malsyned/dparticular/enclosure.FCStd

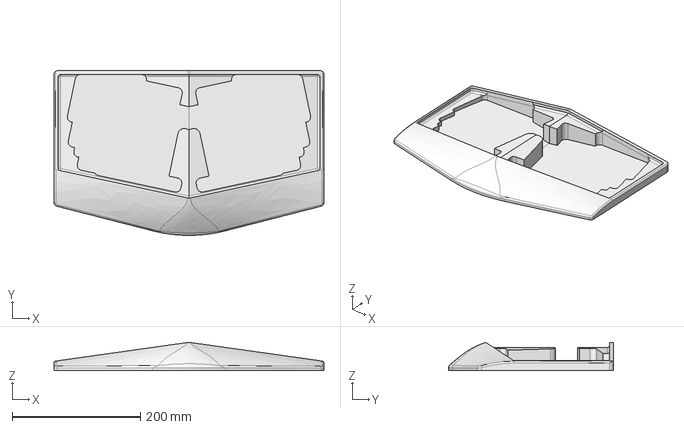
[picture p1: CAD file, 2020-10-07]
enclosure.FCStd
421.7 x 257.6 x 44.1 mm
