malsyned/dparticular/dparticular_left.kicad_pcb

## KiCad design dparticular_left.kicad_pcb (2020-08-25)

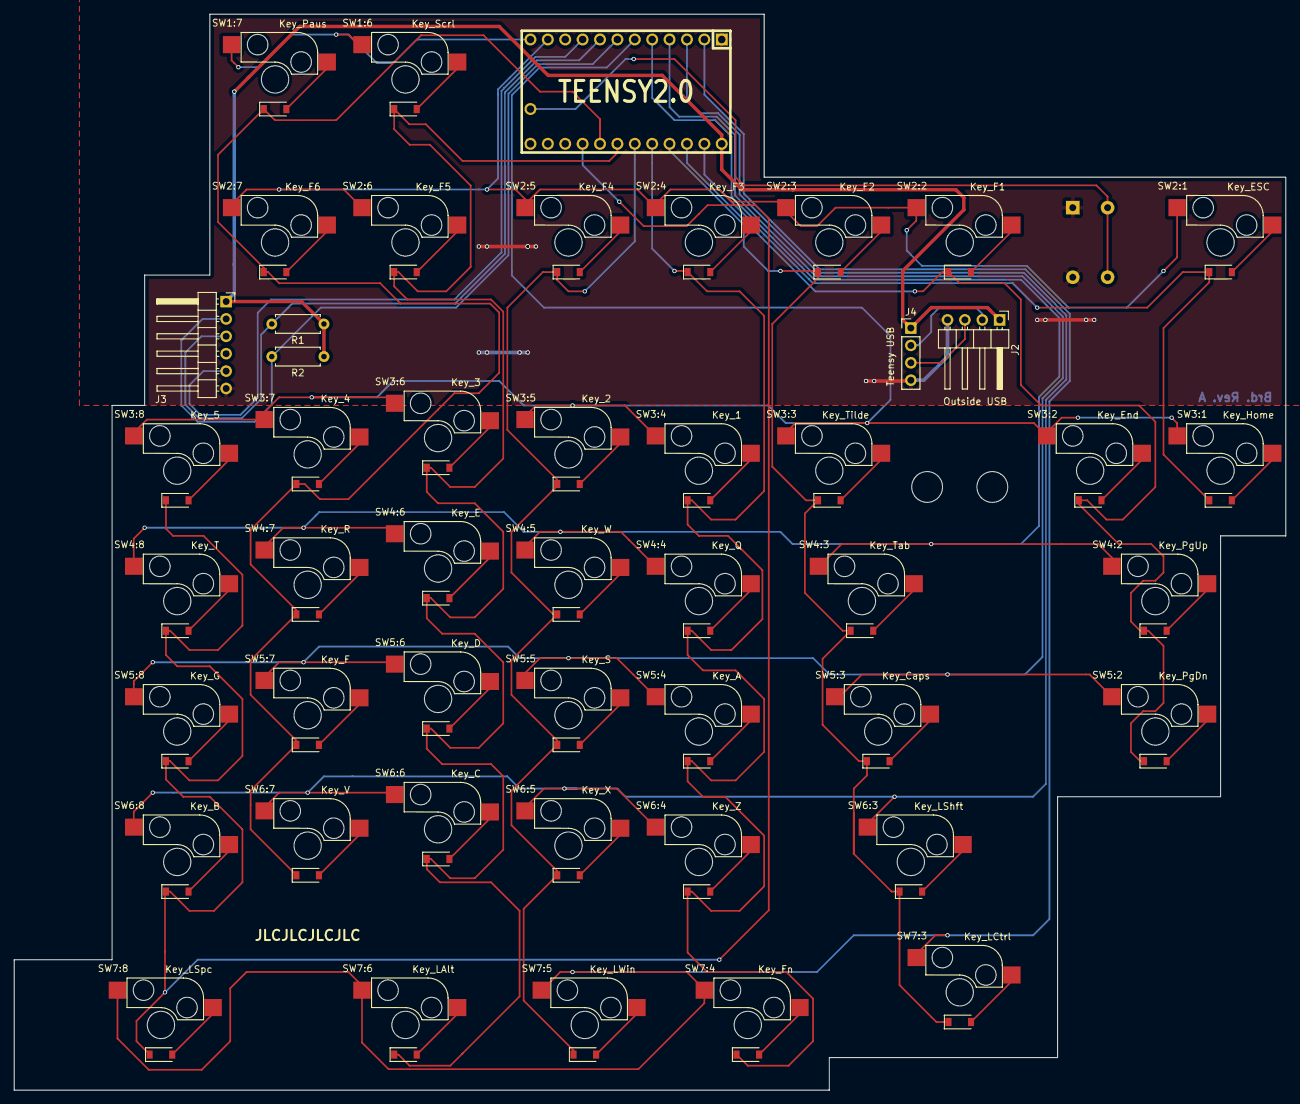
[picture p2: board dparticular_left.kicad_pcb from above]

Board: 2 copper layers, 185.7 x 157.2 mm, 51 parts (1 on the bottom side), 65 nets.

Parts:
H1: USB Strain L; MountingHole_4.5mm
H2: USB Strain R; MountingHole_4.5mm
J2: Outside USB; PinHeader_1x04_P2.54mm_Horizontal
J3: To Right Hand; PinHeader_1x06_P2.54mm_Horizontal
J4: Teensy USB; PinHeader_1x04_P2.54mm_Vertical
R1, R2: 4.7k; R_Axial_DIN0207_L6.3mm_D2.5mm_P7.62mm_Horizontal
SW1: Reset; JB15KP-2A
SW1:6: Key_Scrl; MX_W_DIODE
SW1:7: Key_Paus; MX_W_DIODE
SW2:1: Key_ESC; MX_W_DIODE
SW2:2: Key_F1; MX_W_DIODE
SW2:3: Key_F2; MX_W_DIODE
SW2:4: Key_F3; MX_W_DIODE
SW2:5: Key_F4; MX_W_DIODE
SW2:6: Key_F5; MX_W_DIODE
SW2:7: Key_F6; MX_W_DIODE
SW3:1: Key_Home; MX_W_DIODE
SW3:2: Key_End; MX_W_DIODE
SW3:3: Key_Tilde; MX_W_DIODE
SW3:4: Key_1; MX_W_DIODE
SW3:5: Key_2; MX_W_DIODE
SW3:6: Key_3; MX_W_DIODE
SW3:7: Key_4; MX_W_DIODE
SW3:8: Key_5; MX_W_DIODE
SW4:2: Key_PgUp; MX_W_DIODE
SW4:3: Key_Tab; MX_W_DIODE
SW4:4: Key_Q; MX_W_DIODE
SW4:5: Key_W; MX_W_DIODE
SW4:6: Key_E; MX_W_DIODE
SW4:7: Key_R; MX_W_DIODE
SW4:8: Key_T; MX_W_DIODE
SW5:2: Key_PgDn; MX_W_DIODE
SW5:3: Key_Caps; MX_W_DIODE
SW5:4: Key_A; MX_W_DIODE
SW5:5: Key_S; MX_W_DIODE
SW5:6: Key_D; MX_W_DIODE
SW5:7: Key_F; MX_W_DIODE
SW5:8: Key_G; MX_W_DIODE
SW6:3: Key_LShft; MX_W_DIODE
SW6:4: Key_Z; MX_W_DIODE
SW6:5: Key_X; MX_W_DIODE
SW6:6: Key_C; MX_W_DIODE
SW6:7: Key_V; MX_W_DIODE
SW6:8: Key_B; MX_W_DIODE
SW7:3: Key_LCtrl; MX_W_DIODE
SW7:4: Key_Fn; MX_W_DIODE
SW7:5: Key_LWin; MX_W_DIODE
SW7:6: Key_LAlt; MX_W_DIODE
SW7:8: Key_LSpc; MX_W_DIODE
U2: TEENSY2.0; TEENSY_2.0_EDGES_ONLY

Connections:
+5V: J2.1, J3.1, J4.1, R1.1, R2.1, U2.29
/COL1: SW2:1.4, SW3:1.4, U2.28
/COL2: SW2:2.4, SW3:2.4, SW4:2.4, SW5:2.4, U2.27
/COL3: SW2:3.4, SW3:3.4, SW4:3.4, SW5:3.4, SW6:3.4, SW7:3.4, U2.26
/COL4: SW2:4.4, SW3:4.4, SW4:4.4, SW5:4.4, SW6:4.4, SW7:4.4, U2.25
/COL5: SW2:5.4, SW3:5.4, SW4:5.4, SW5:5.4, SW6:5.4, SW7:5.4, U2.24
/COL6: SW1:6.4, SW2:6.4, SW3:6.4, SW4:6.4, SW5:6.4, SW6:6.4, SW7:6.4, U2.23
/COL7: SW1:7.4, SW2:7.4, SW3:7.4, SW4:7.4, SW5:7.4, SW6:7.4, U2.22
/COL8: SW3:8.4, SW4:8.4, SW5:8.4, SW6:8.4, SW7:8.4, U2.21
/LED_D: J3.5, U2.9
/ROW1: SW1:6.1, SW1:7.1, U2.12
/ROW2: SW2:1.1, SW2:2.1, SW2:3.1, SW2:4.1, SW2:5.1, SW2:6.1, SW2:7.1, U2.11
/ROW3: SW3:1.1, SW3:2.1, SW3:3.1, SW3:4.1, SW3:5.1, SW3:6.1, SW3:7.1, SW3:8.1, U2.6
/ROW4: SW4:2.1, SW4:3.1, SW4:4.1, SW4:5.1, SW4:6.1, SW4:7.1, SW4:8.1, U2.5
/ROW5: SW5:2.1, SW5:3.1, SW5:4.1, SW5:5.1, SW5:6.1, SW5:7.1, SW5:8.1, U2.4
/ROW6: SW6:3.1, SW6:4.1, SW6:5.1, SW6:6.1, SW6:7.1, SW6:8.1, U2.3
/ROW7: SW7:3.1, SW7:4.1, SW7:5.1, SW7:6.1, SW7:8.1, U2.2
/SCL: J3.2, R2.2, U2.7
/SDA: J3.3, R1.2, U2.8
/USB_DN: J2.2, J4.2
/USB_DP: J2.3, J4.3
GND: J2.4, J3.6, J4.4, SW1.1, SW1.2, U2.1
unnamed: SW1.3, SW1.4, U2.16
unnamed: SW1:6.2, SW1:6.3
unnamed: SW1:7.2, SW1:7.3
unnamed: SW2:1.2, SW2:1.3
unnamed: SW2:2.2, SW2:2.3
unnamed: SW2:3.2, SW2:3.3
unnamed: SW2:4.2, SW2:4.3
unnamed: SW2:5.2, SW2:5.3
unnamed: SW2:6.2, SW2:6.3
unnamed: SW2:7.2, SW2:7.3
unnamed: SW3:1.2, SW3:1.3
unnamed: SW3:2.2, SW3:2.3
unnamed: SW3:3.2, SW3:3.3
unnamed: SW3:4.2, SW3:4.3
unnamed: SW3:5.2, SW3:5.3
unnamed: SW3:6.2, SW3:6.3
unnamed: SW3:7.2, SW3:7.3
unnamed: SW3:8.2, SW3:8.3
unnamed: SW4:2.2, SW4:2.3
unnamed: SW4:3.2, SW4:3.3
unnamed: SW4:4.2, SW4:4.3
unnamed: SW4:5.2, SW4:5.3
unnamed: SW4:6.2, SW4:6.3
unnamed: SW4:7.2, SW4:7.3
unnamed: SW4:8.2, SW4:8.3
unnamed: SW5:2.2, SW5:2.3
unnamed: SW5:3.2, SW5:3.3
unnamed: SW5:4.2, SW5:4.3
unnamed: SW5:5.2, SW5:5.3
unnamed: SW5:6.2, SW5:6.3
unnamed: SW5:7.2, SW5:7.3
unnamed: SW5:8.2, SW5:8.3
unnamed: SW6:3.2, SW6:3.3
unnamed: SW6:4.2, SW6:4.3
unnamed: SW6:5.2, SW6:5.3
unnamed: SW6:6.2, SW6:6.3
unnamed: SW6:7.2, SW6:7.3
unnamed: SW6:8.2, SW6:8.3
unnamed: SW7:3.2, SW7:3.3
unnamed: SW7:4.2, SW7:4.3
unnamed: SW7:5.2, SW7:5.3
unnamed: SW7:6.2, SW7:6.3
unnamed: SW7:8.2, SW7:8.3
