malsyned/dparticular/dparticular_right.kicad_pcb

## KiCad design dparticular_right.kicad_pcb (2020-08-25)

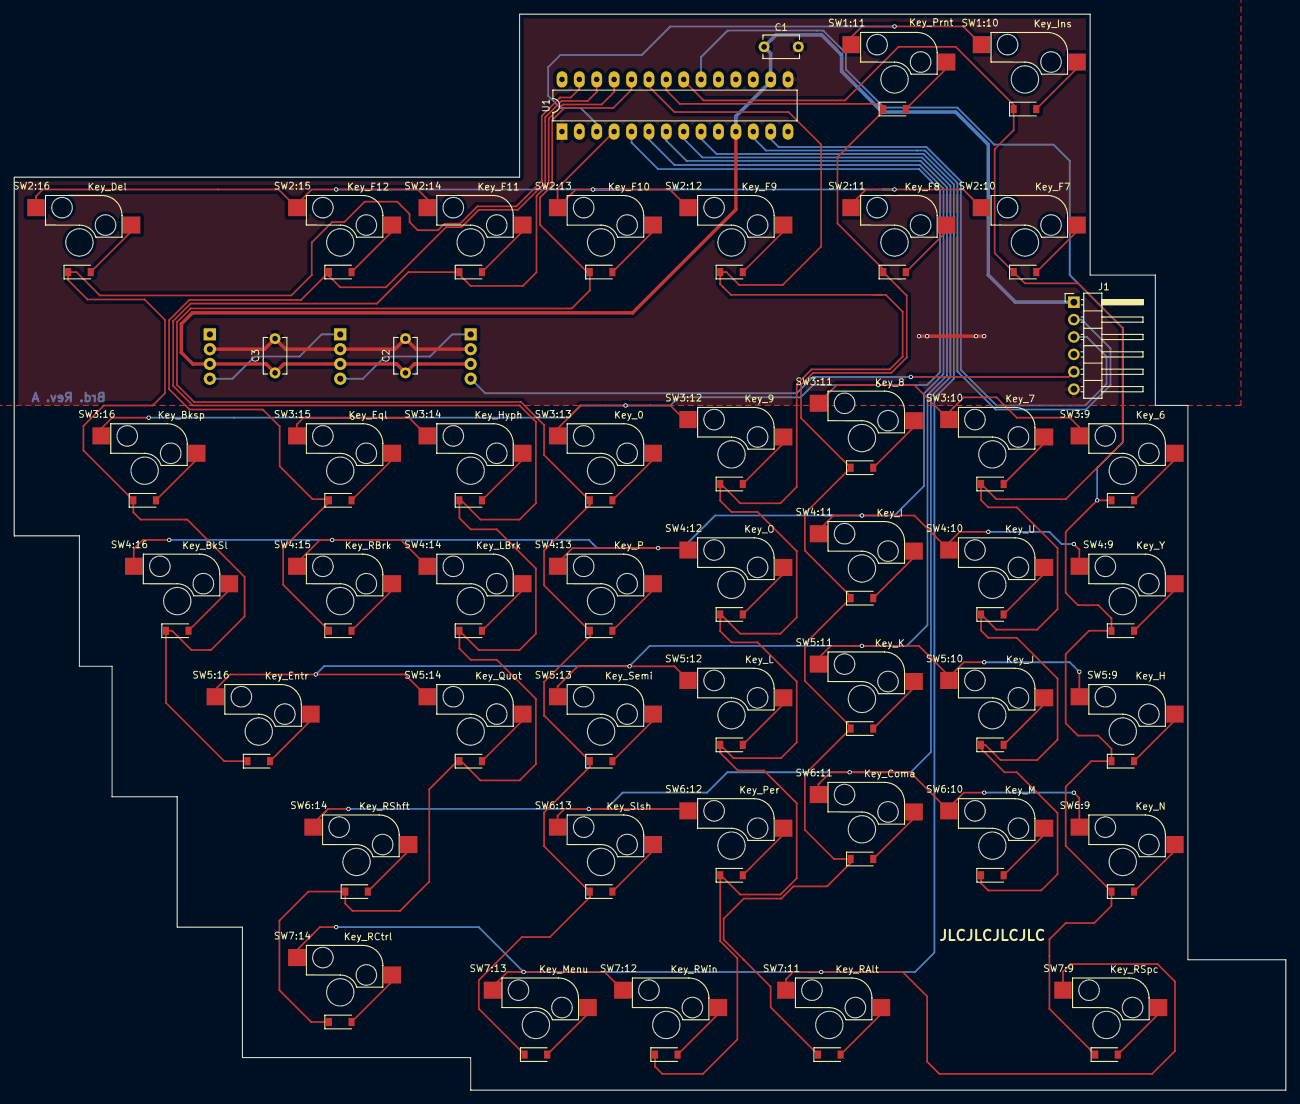
[picture p3: board dparticular_right.kicad_pcb from above]

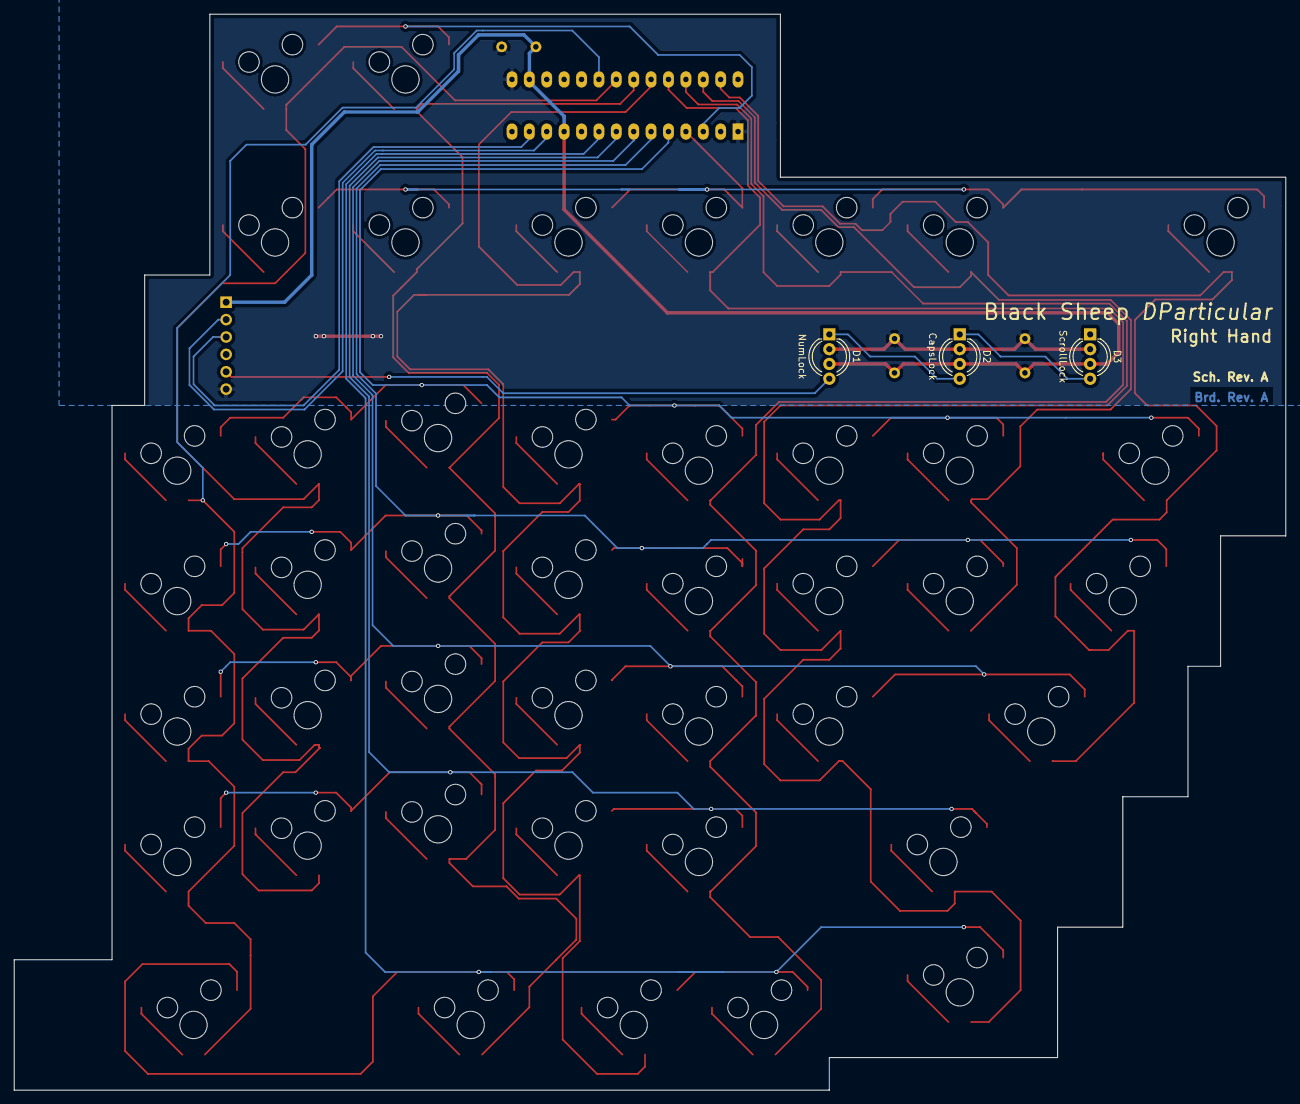
[picture p4: board dparticular_right.kicad_pcb from below]

Board: 2 copper layers, 185.7 x 157.2 mm, 51 parts (3 on the bottom side), 65 nets.

Parts:
C1, C2, C3: 0.1uF; C_Disc_D5.1mm_W3.2mm_P5.00mm
D1: NumLock; LED_D5.0mm-4_RGB_Wide_Pins
D2: CapsLock; LED_D5.0mm-4_RGB_Wide_Pins
D3: ScrollLock; LED_D5.0mm-4_RGB_Wide_Pins
J1: To Left Hand; PinHeader_1x06_P2.54mm_Horizontal
SW1:10: Key_Ins; MX_W_DIODE
SW1:11: Key_Prnt; MX_W_DIODE
SW2:10: Key_F7; MX_W_DIODE
SW2:11: Key_F8; MX_W_DIODE
SW2:12: Key_F9; MX_W_DIODE
SW2:13: Key_F10; MX_W_DIODE
SW2:14: Key_F11; MX_W_DIODE
SW2:15: Key_F12; MX_W_DIODE
SW2:16: Key_Del; MX_W_DIODE
SW3:9: Key_6; MX_W_DIODE
SW3:10: Key_7; MX_W_DIODE
SW3:11: Key_8; MX_W_DIODE
SW3:12: Key_9; MX_W_DIODE
SW3:13: Key_0; MX_W_DIODE
SW3:14: Key_Hyph; MX_W_DIODE
SW3:15: Key_Eql; MX_W_DIODE
SW3:16: Key_Bksp; MX_W_DIODE
SW4:9: Key_Y; MX_W_DIODE
SW4:10: Key_U; MX_W_DIODE
SW4:11: Key_I; MX_W_DIODE
SW4:12: Key_O; MX_W_DIODE
SW4:13: Key_P; MX_W_DIODE
SW4:14: Key_LBrk; MX_W_DIODE
SW4:15: Key_RBrk; MX_W_DIODE
SW4:16: Key_BkSl; MX_W_DIODE
SW5:9: Key_H; MX_W_DIODE
SW5:10: Key_J; MX_W_DIODE
SW5:11: Key_K; MX_W_DIODE
SW5:12: Key_L; MX_W_DIODE
SW5:13: Key_Semi; MX_W_DIODE
SW5:14: Key_Quot; MX_W_DIODE
SW5:16: Key_Entr; MX_W_DIODE
SW6:9: Key_N; MX_W_DIODE
SW6:10: Key_M; MX_W_DIODE
SW6:11: Key_Coma; MX_W_DIODE
SW6:12: Key_Per; MX_W_DIODE
SW6:13: Key_Slsh; MX_W_DIODE
SW6:14: Key_RShft; MX_W_DIODE
SW7:9: Key_RSpc; MX_W_DIODE
SW7:11: Key_RAlt; MX_W_DIODE
SW7:12: Key_RWin; MX_W_DIODE
SW7:13: Key_Menu; MX_W_DIODE
SW7:14: Key_RCtrl; MX_W_DIODE
U1: MCP23018; DIP-28_W7.62mm_LongPads

Connections:
+5V: C1.1, C2.1, C3.1, D1.3, D2.3, D3.3, J1.1, U1.11, U1.16
/COL9: SW3:9.4, SW4:9.4, SW5:9.4, SW6:9.4, SW7:9.4, U1.20
/COL10: SW1:10.4, SW2:10.4, SW3:10.4, SW4:10.4, SW5:10.4, SW6:10.4, U1.21
/COL11: SW1:11.4, SW2:11.4, SW3:11.4, SW4:11.4, SW5:11.4, SW6:11.4, SW7:11.4, U1.22
/COL12: SW2:12.4, SW3:12.4, SW4:12.4, SW5:12.4, SW6:12.4, SW7:12.4, U1.23
/COL13: SW2:13.4, SW3:13.4, SW4:13.4, SW5:13.4, SW6:13.4, SW7:13.4, U1.24
/COL14: SW2:14.4, SW3:14.4, SW4:14.4, SW5:14.4, SW6:14.4, SW7:14.4, U1.25
/COL15: SW2:15.4, SW3:15.4, SW4:15.4, U1.26
/COL16: SW2:16.4, SW3:16.4, SW4:16.4, SW5:16.4, U1.27
/LED_D: D1.4, J1.5
/ROW1: SW1:10.1, SW1:11.1, U1.3
/ROW2: SW2:10.1, SW2:11.1, SW2:12.1, SW2:13.1, SW2:14.1, SW2:15.1, SW2:16.1, U1.4
/ROW3: SW3:9.1, SW3:10.1, SW3:11.1, SW3:12.1, SW3:13.1, SW3:14.1, SW3:15.1, SW3:16.1, U1.5
/ROW4: SW4:9.1, SW4:10.1, SW4:11.1, SW4:12.1, SW4:13.1, SW4:14.1, SW4:15.1, SW4:16.1, U1.6
/ROW5: SW5:9.1, SW5:10.1, SW5:11.1, SW5:12.1, SW5:13.1, SW5:14.1, SW5:16.1, U1.7
/ROW6: SW6:9.1, SW6:10.1, SW6:11.1, SW6:12.1, SW6:13.1, SW6:14.1, U1.8
/ROW7: SW7:9.1, SW7:11.1, SW7:12.1, SW7:13.1, SW7:14.1, U1.9
/SCL: J1.2, U1.12
/SDA: J1.3, U1.13
GND: C1.2, C2.2, C3.2, D1.2, D2.2, D3.2, J1.6, U1.1, U1.15
unnamed: D1.1, D2.4
unnamed: D2.1, D3.4
unnamed: SW1:10.2, SW1:10.3
unnamed: SW1:11.2, SW1:11.3
unnamed: SW2:10.2, SW2:10.3
unnamed: SW2:11.2, SW2:11.3
unnamed: SW2:12.2, SW2:12.3
unnamed: SW2:13.2, SW2:13.3
unnamed: SW2:14.2, SW2:14.3
unnamed: SW2:15.2, SW2:15.3
unnamed: SW2:16.2, SW2:16.3
unnamed: SW3:9.2, SW3:9.3
unnamed: SW3:10.2, SW3:10.3
unnamed: SW3:11.2, SW3:11.3
unnamed: SW3:12.2, SW3:12.3
unnamed: SW3:13.2, SW3:13.3
unnamed: SW3:14.2, SW3:14.3
unnamed: SW3:15.2, SW3:15.3
unnamed: SW3:16.2, SW3:16.3
unnamed: SW4:9.2, SW4:9.3
unnamed: SW4:10.2, SW4:10.3
unnamed: SW4:11.2, SW4:11.3
unnamed: SW4:12.2, SW4:12.3
unnamed: SW4:13.2, SW4:13.3
unnamed: SW4:14.2, SW4:14.3
unnamed: SW4:15.2, SW4:15.3
unnamed: SW4:16.2, SW4:16.3
unnamed: SW5:9.2, SW5:9.3
unnamed: SW5:10.2, SW5:10.3
unnamed: SW5:11.2, SW5:11.3
unnamed: SW5:12.2, SW5:12.3
unnamed: SW5:13.2, SW5:13.3
unnamed: SW5:14.2, SW5:14.3
unnamed: SW5:16.2, SW5:16.3
unnamed: SW6:9.2, SW6:9.3
unnamed: SW6:10.2, SW6:10.3
unnamed: SW6:11.2, SW6:11.3
unnamed: SW6:12.2, SW6:12.3
unnamed: SW6:13.2, SW6:13.3
unnamed: SW6:14.2, SW6:14.3
unnamed: SW7:9.2, SW7:9.3
unnamed: SW7:11.2, SW7:11.3
unnamed: SW7:12.2, SW7:12.3
unnamed: SW7:13.2, SW7:13.3
unnamed: SW7:14.2, SW7:14.3
