malsyned/dparticular/(commit log)

2020-06-24 DParticular initial commit, incomplete schematic
    [dparticular.kicad_pcb, dparticular.sch, dparticular_left.sch, dparticular_right.sch]
2020-07-01 Complete rough schematic
2020-07-06 Add enclosure 3D model
    [enclosure.FCStd]
2020-07-06 Schematic revisions; first attempt at layout
    [dparticular.kicad_pcb, dparticular_left.sch, dparticular_right.sch]
2020-07-07 Beginning of separate right board project
    [dparticular_right.kicad_pcb, dparticular_right.sch]
2020-07-07 Preliminary placements for right hand
    [dparticular_right.kicad_pcb]
2020-07-07 Preliminary placements for left hand
    [dparticular_left.kicad_pcb]
2020-07-07 Deleted combined net and pcb
    [dparticular.kicad_pcb]
2020-07-07 Fixed footprints on switches and headers
    [dparticular_left.kicad_pcb, dparticular_left.sch, dparticular_right.kicad_pcb, dparticular_right.sch]
2020-07-07 Edge cuts, net list exports
    [dparticular_left.kicad_pcb, dparticular_left.sch, dparticular_right.kicad_pcb]
2020-07-07 .gitignore: kicad autosave files
2020-07-07 LED orientation and wiring
    [dparticular_right.kicad_pcb]
2020-07-08 LED labeling, schematic cosmetics
    [dparticular_right.sch]
2020-07-08 Design rules compatible with common prototype board manufacturers
    Maximums that work with JLCPCB, ALLPCB, and Elecrow
    [dparticular_left.kicad_pcb, dparticular_right.kicad_pcb]
2020-07-08 right hand PCB: Column traces
    [dparticular_right.kicad_pcb]
2020-07-08 Fix LED name order
    [dparticular_right.sch]
2020-07-09 Right hand completed layout
    [dparticular_right.kicad_pcb, dparticular_right.sch]
2020-07-09 Left hand: updated solder mask design rules
2020-07-09 Moved USB headers to reduce width of top rectangle
    [dparticular_left.kicad_pcb]
2020-07-09 Right hand: don't run traces between pads
    [dparticular_right.kicad_pcb]
2020-07-09 Right hand: eliminate right angles in columns 9 and 10
    [dparticular_right.kicad_pcb]
2020-07-09 Right hand: eliminate right angles in remaining columns
    [dparticular_right.kicad_pcb]
2020-07-09 Right hand: Eliminate all remaining right angles
    [dparticular_right.kicad_pcb]
2020-07-09 MX_W_DIODE: Cleaned up silk screen for hot plug socket
    [dparticular_left.kicad_pcb, dparticular_right.kicad_pcb]
2020-07-09 Left hand: Changed uC pin assignments; Routed diode tracks and power rail
    [dparticular_left.kicad_pcb, dparticular_left.sch]
2020-07-09 Left hand: Routed columns
    [dparticular_left.kicad_pcb]
2020-07-09 Left hand: Completed routing
    [dparticular_left.kicad_pcb]
2020-07-09 Left hand: Cleaned up ground paths
    [dparticular_left.kicad_pcb]
2020-07-10 enclosure: 1/16" margin around PCBs
    [enclosure.FCStd]
2020-07-10 enclosure: clean up inner edge
    [enclosure.FCStd]
2020-07-10 enclosure: tweaked palm rest dimensions and rear margin
    [enclosure.FCStd]
2020-07-10 enclosure: screw position sketch
    [enclosure.FCStd]
2020-07-10 enclosure: threaded inserts
    [enclosure.FCStd]
2020-07-10 enclosure: screw cutout cylinders
    [enclosure.FCStd]
2020-07-10 enclosure: solid plate with screw holes
    [enclosure.FCStd]
2020-07-10 Right hand pcb: Move LEDs half a key to the left
    This let's them be more visible between keycaps from a shallow viewing
    angle.
    [dparticular_right.kicad_pcb]
2020-07-10 Right hand PCB: Move traces farther away from drill holes
    [dparticular_right.kicad_pcb]
2020-07-14 PCBs: 3D models for Teensy 2.0 and MX sockets & diodes
    [dparticular_left.kicad_pcb, dparticular_right.kicad_pcb]
2020-07-14 Left Hand PCB: Remove 3D header for Teensy USB solder points
    [dparticular_left.kicad_pcb]
2020-07-18 Left hand PCB: match fill zone size to right hand
    [dparticular_left.kicad_pcb]
2020-07-18 Teensy 2.0 Footprint: Assemble 3D model from upstream components
    [dparticular_left.kicad_pcb]
2020-07-18 MX_W_DIODE: Tweak socket 3D model scaling to compensate for upstream error
    [dparticular_left.kicad_pcb, dparticular_right.kicad_pcb]
2020-07-19 enclosure: actually solid plate with screw holes
    [enclosure.FCStd]
2020-07-19 enclosure: plate: clearance and corner radius
    [enclosure.FCStd]
2020-07-19 enclosure: store distance from screw to edges in spreadsheet
    [enclosure.FCStd]
2020-07-19 enclosure: threaded insert drill guides
    [enclosure.FCStd]
2020-07-19 enclosure: Right top solid with drill holes
    [enclosure.FCStd]
2020-07-19 enclosure: import and position latest PCB STEP files
2020-07-19 enclosure: mirror right solid plate and top to left half
2020-07-19 enclosure: holes in top and plate for lock status LEDs
    The offset of the centers from the F-keys row was hand-calculated by
    examining both the PCB layout and the footprint for the LED in question.
    If that part of the PCB layout changes, this will have to be
    hand-recomputed.
2020-07-19 enclosure: round outside edges of top pieces
    I removed the PCBs in this commit as well. Some STEP setting on my
    desktop was causing them to be huge and Github was throwing warnings.
2020-07-19 enclosure: Cutouts in plates and tops
    [enclosure.FCStd]
2020-07-21 enclosure: adjust border after pleather experiments
    [enclosure.FCStd]
2020-07-22 Left PCB: Mounting holes for USB strain relief zip ties
    [dparticular_left.kicad_pcb, dparticular_left.sch]
2020-07-25 Left Hand PCB: Reset switch for Teensy 2.0
    [dparticular_left.kicad_pcb, dparticular_left.sch]
2020-07-25 Left Hand PCB: Shorter switch, properly positioned
    [dparticular_left.kicad_pcb, dparticular_left.sch]
2020-07-26 Teensy 2.0 3D Model: Single pin (RST) connector for back edge
    [dparticular_left.kicad_pcb]
2020-07-26 Left Hand PCB: Move traces out from under Reset switch
    [dparticular_left.kicad_pcb]
2020-07-26 Reset Switch: Use schematic symbol with correct pinout
    [dparticular_left.kicad_pcb, dparticular_left.sch]
2020-07-26 enclosure: Reset switch cuts in left plate and top
    [enclosure.FCStd]
2020-07-26 Reset Switch: Move between ESC and F1
    [dparticular_left.kicad_pcb, enclosure.FCStd]
2020-07-26 Right Hand PCB: Make some space for potential future drill holes
    [dparticular_right.kicad_pcb]
2020-07-27 enclosure: Adjust margins and enclosure width
    The front margin is reduced from 0.33" to 0.25"
    The side margin is moved and increased to fit potential future arrow keys
    The enclosure wall width is decreased from 3/8" to 1/4"
    [enclosure.FCStd]
2020-07-28 enclosure: give the left half mirror a real name
    [enclosure.FCStd]
2020-07-28 enclosure: Add flat face to front edge
    [enclosure.FCStd]
2020-07-28 enclosure: initial sketch of palm pad pockets
    [enclosure.FCStd]
2020-07-28 enclosure palm pad cuts: round corners
    [enclosure.FCStd]
2020-07-30 Right Hand PCB: Moved LEDs half a key right and centered them vertically
    I made this change after discovering that, head on in perspective view,
    the LEDs are more visible centered on the keys than on the key edges.
    [dparticular_right.kicad_pcb, enclosure.FCStd]
2020-07-30 Righ Hand PCB: improved ground plane coverage
    [dparticular_right.kicad_pcb]
2020-07-31 enclosure: Palm pad dimensions referenced to actual measurements
    This allowed me to confidently parameterize a lot more of the dimensions
    that make up the front into the spreadsheet.
    [enclosure.FCStd]
2020-07-31 enclosure: backed out to before wrong fillet. Right fillet freezes FreeCAD
    [enclosure.FCStd]
2020-08-02 enclosure: snub nose; work around fillet crash
    [enclosure.FCStd]
2020-08-03 enclosure: tighten palm pad tolerances
    [enclosure.FCStd]
2020-08-03 enclosure: small dimension adjustments along the palm rest
    [enclosure.FCStd]
2020-08-03 enclosure: Fillets on inner corners of main pocket
    [enclosure.FCStd]
2020-08-03 enclosure: extra clearance for PCB corners in cutout
    [enclosure.FCStd]
2020-08-03 enclosure: Fix boundaries of top piece
    [enclosure.FCStd]
2020-08-03 enclosure: Fillets on shallow part of main pocket
    [enclosure.FCStd]
2020-08-03 Left Hand PCB: Harmonize inter-board ribbon header orientations
    [dparticular_left.kicad_pcb]
2020-08-05 Right Hand PCB: Tidying and ground fill expanding
    [dparticular_right.kicad_pcb]
2020-08-05 Right Hand Schematic: Deleted stray NC X
    [dparticular_right.sch]
2020-08-05 Palm pad footprint: tweaks after comparing sketch printout with real unit
    [enclosure.FCStd]
2020-08-07 enclosure: 1/2" end mill, 1/4" ball nose
    [enclosure.FCStd]
2020-08-07 enclosure: bottom radius for shallow pocket
    [enclosure.FCStd]
2020-08-07 enclosure: 20% safety margin on all functional fillets
    [enclosure.FCStd]
2020-08-07 enclosure: Bigger cutout margin on inside edges
    [enclosure.FCStd]
2020-08-07 enclosure: ensure pocket radii don't interfere with PCB corners
    [enclosure.FCStd]
2020-08-07 enclosure: rounder nose
    [enclosure.FCStd]
2020-08-07 enclosure: pocket radii >= 1/3 pocket depth
    [enclosure.FCStd]
2020-08-07 enclosure: simplified palm pad cut fillet instructions
    [enclosure.FCStd]
2020-08-08 enclosure: Reduce ball-nose fillets to exact size
    Per Doug Ruuska
    [enclosure.FCStd]
2020-08-08 enclosure: Added back in some top edge fillets in 3D region
    [enclosure.FCStd]
2020-08-09 PCBs: Clean up via line by line analysis
    [dparticular_left.kicad_pcb, dparticular_right.kicad_pcb]
2020-08-09 PCBs: Move vias off silk screen
    [dparticular_left.kicad_pcb, dparticular_right.kicad_pcb]
2020-08-09 PCBs: More proofreading and cleanup
    [dparticular_left.kicad_pcb, dparticular_right.kicad_pcb]
2020-08-09 PCBs: Added JLC Order Number placeholders
    [dparticular_left.kicad_pcb, dparticular_right.kicad_pcb]
2020-08-09 PCBs: Edge cuts to 6 mils for JLCPCB
    [dparticular_left.kicad_pcb, dparticular_right.kicad_pcb]
2020-08-09 enclosure: Larger plate LED holes for lens shelf
    [enclosure.FCStd]
2020-08-09 PCBs: US Letter page size
    [dparticular_left.kicad_pcb, dparticular_right.kicad_pcb]
2020-08-09 Schematic: Filled in Title Block; USLetter page size
    [dparticular.sch, dparticular_left.sch, dparticular_right.sch]
2020-08-09 PCBs: Filled in Title Block
    [dparticular_left.kicad_pcb, dparticular_right.kicad_pcb]
2020-08-09 PCBs: Branding and revision IDs
    [dparticular_left.kicad_pcb, dparticular_right.kicad_pcb]
2020-08-10 PCBs: Plotting options
    [dparticular_left.kicad_pcb, dparticular_right.kicad_pcb]
2020-08-10 enclosure: sleeker nose sculpt
    [enclosure.FCStd]
2020-08-11 Tops: 0.5mm Larger clearance to account for pocket fillet
    [enclosure.FCStd]
2020-08-12 enclosure: simplified switch plate cutouts
    According to nevin on geekhack, Kailh BOX switches don't work with the
    "MX Openable Cutout" and using simple squares saves money on laser
    cutting.
    https://geekhack.org/index.php?topic=108027.0
    [enclosure.FCStd]
2020-08-12 enclosure: corrected rotation on left hand stabilizers
    [enclosure.FCStd]
2020-08-13 tops and plates: vectors and dimension drawings
    [enclosure.FCStd]
2020-08-14 Drawings: Flip and reorient for space; Add parts for guiding drill holes
    [enclosure.FCStd]
2020-08-15 Top Drawing: More complete dimensional information
    [enclosure.FCStd]
2020-08-15 Drawings: Link to base shapes via Facebinders
    [enclosure.FCStd]
2020-08-21 Dimensioned drawings: ensure labels don't overlap in metric
    [enclosure.FCStd]
2020-08-21 Right Plate: Enlarge LED cutouts to avoid shorting pins
    [enclosure.FCStd]
2020-08-25 Kailh Socket: Fix 3D part orientation
2020-08-25 MX Footprint: Fix socket silkscreen
2020-08-25 enclosure: higher resolution palm pad sketch
    [enclosure.FCStd]
2020-08-25 enclosure: actual palm pad photo; palm pad footprint tweaks
2020-08-25 Kailh Socket Footprint: Update PCBs from footprint
    [dparticular_left.kicad_pcb, dparticular_right.kicad_pcb]
2020-09-19 enclosure: separate control of back thickness and side thickness
2020-09-29 enclosure: removed leather palm pads; reduced size front-to-back
2020-10-06 enclosure: convex palm rest
    [enclosure.FCStd]
2020-10-07 enclosure: longer palm rest outside edges
    [enclosure.FCStd]
