malsyned/dparticular/(notices)

Notices in the files:
dparticular_right.kicad_pcb:
License: CC BY-SA 4.0
dparticular_left.sch:
https://creativecommons.org/licenses/by-sa/4.0
